HarringayMakerSpace/usb-esp/doc/IMAG0624a.jpg

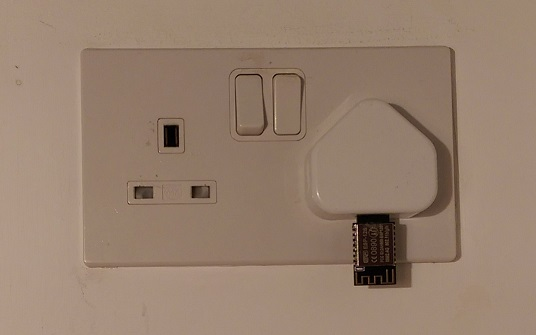
doc/IMAG0624a.jpg
